capantoja/EstudioVirtualRepo/Documentacion/encoder.gif

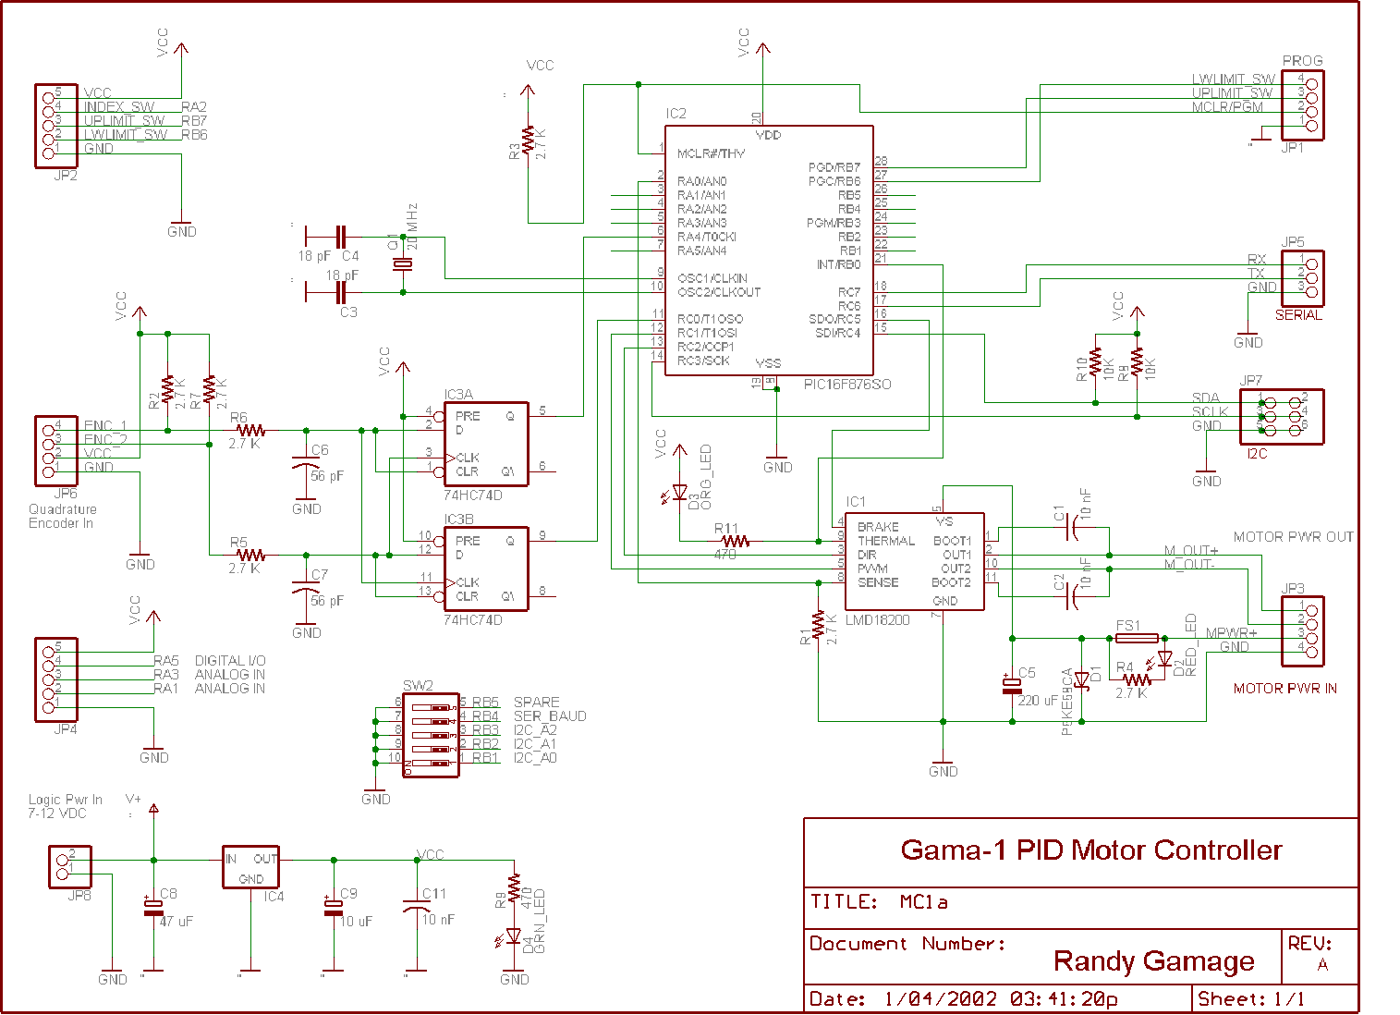
Documentacion/encoder.gif
