capantoja/EstudioVirtualRepo/Hardware/BOM.xlsx

Sheet: COMPRAS_PCB
 | UNIDADES DE PCBs: | 0
Cant requerida | Designator | Value | Descripción | Referencia Fabricante | Case | Web Link | Cantidad mínima de venta en distribuidor | Costo por un. Min. de venta | Costo por unidad | Unidades requeridas para 1 equipo | Unidades a comprar (para N PCB) | Costo de los componentes a comprar (DOLARES) | Costo de los componentes a comprar (PESOS)
COMPRAS INTERNACIONALES PCB
4 | C1,C2,C3,C4 | 10uF | Condensador de Tantalio de 10μF - 16V de montaje superficial. Tolerancia ± 10 % | CT1206 10UF16V | 1206 | http://www.sigmaelectronica.net/ct1206-10uf16v-p-1156.html | 1 | 348 | 348.000 | 4.00 |  |  | 1392
11 | C5,C6,C7,C8,C9,C10,C11,C12,C13,C14,C15 | 0.1uF | Condensador cerámico de 0.1μF - 50V de montaje superficial. Tamaño 0805 (2x1.2x1mm) | CC0805 0.1UF50 | 0805 | http://www.sigmaelectronica.net/cc0805-01uf50-p-1077.html | 10 | 58 | 58.000 | 11.00 |  |  | 638
1 | CON1 | JACK |  |  |  |  |  |  |  |  |  |  | 0
1 | J1 | DB9 | Conector DB- 9 Hembra para impreso de 9 pines. | DB9-H-IMP | - | http://www.sigmaelectronica.net/db9-h-imp-p-1578.html | 1 | 696 | 696.000 | 1.00 |  |  | 696
4 | K1,K2,K3,K4 | CONN 1X3 |  |  |  |  |  |  |  |  |  |  | 0
2 | P1,P2 | CONN 25X2 FEMALE |  |  |  |  |  |  |  |  |  |  | 0
4 | P3,P4,P5,P6 | CONN 1X5 |  |  |  |  |  |  |  |  |  |  | 0
8 | R1,R2,R3,R4,R5,R6,R7,R8 | 2.2K | Resistencia superficial de 2.2 KΩ, 1/10W | R0603 2.2K 5% | 0603 | http://www.sigmaelectronica.net/r0603-p-1675.html | 10 | 35 | 35.000 | 10.00 |  |  | 350
4 | U1,U3,U4,U6 | 74HC74M | 2 Flip-Flops tipo D con seteado y borrado. Tecnología High speed CMOS | 74HC74M | SOIC14 | http://www.sigmaelectronica.net/74hc74m-p-1138.html | 1 | 696 | 696.000 | 4.00 |  |  | 2784
1 | U5 | MAX3232 | RS232 DRIVER | MAX3232CSE | SO16 | http://www.sigmaelectronica.net/max3232cse-p-948.html | 1 | 3190 | 3190.000 | 1.00 |  |  | 3190
1 | U2 | 74HC244M | 8 buffers / tarnsmisores de línea / receptores de línea con salidas 3-state no invertidas | 74HC244M | SOIC20 | http://www.sigmaelectronica.net/74hc244m-p-704.html | 1 | 1160 | 1160.000 | 1.00 |  |  | 1160
1 |  | ATSAM3N4A | Microcontrolador 32 bits | ATSAM3N4AA-AU | LQFP48 | http://www.sigmaelectronica.net/atsam3n4aa-p-1955.html | 1 | 15486 | 15486.000 | 1.00 |  | TOTAL | 10210
COMPRAS NACIONALES PCB
 |  |  |  |  |  |  | 1 | 0 | 0.00 | 1.00 | #REF! | NV | #REF!
 |  |  |  |  |  |  | 1 | 0 | 0.00 | 1.00 | #REF! | NV | #REF!
 |  |  |  |  |  |  | 1 | 0 | 0.00 | 1.00 | #REF! | NV | #REF!
 |  |  |  |  |  |  | 1 | 0 | 0.00 | 1.00 | #REF! | NV | #REF!
 |  |  |  |  |  |  | 1 | 0 | 0.00 | 1.00 | #REF! | NV | #REF!
 |  |  |  |  |  |  | 1 | 0 | 0.00 | 1.00 | #REF! | NV | #REF!
COMPRAS INTERNACIONALES ADICIONALES AL ENSAMBLE
 |  |  |  |  |  |  | 1 | 0.89 | 0.89 | 1.00 | 1 | 0.890 | NV
 |  |  |  |  |  |  | 1 | 0.52 | 0.52 | 1.00 | 1 | 0.520 | NV
 |  |  |  |  |  |  | 1 | 0.82 | 0.82 | 5.00 | 5 | 0.000
COMPRAS NACIONALES ADICIONALES AL ENSAMBLE
 |  |  |  |  |  |  |  |  |  |  |  | TOTAL USD | 1.410
42 | TOTAL COMPONENTES POR UNIDAD: |  |  |  |  |  |  |  |  |  |  | TOTAL PESOS | #REF!
 | ÚLTIMA REVISIÓN DE STOCK: | 24/07/2014
 |  |  |  |  |  |  |  | UNIDAD PROMEDIO DOLARES: |  |  |  |  | #DIV/0!
 |  |  |  |  |  |  |  | UNIDAD PROMEDIO PESOS: |  |  |  |  | #REF!
 |  |  |  |  |  |  |  |  |  |  |  | Página 1 de 1

Sheet: COMPRAS_EQUIPOS
 |  | DEPENDENCIA |  |  | CODIGO: XXXXXXX
 |  |  |  |  | VERSION: XXXXXX
 |  | COMPRAS EQUIPOS |  |  | FECHA: [Seleccione la fecha]
Cant requerida | Nombre | Descripción | Referencia Fabricante | Web Link | Case | Web Link | Costo por unidad | Unidades a comprar | Costo de equipos (DOLARES) | Costo de equipos (PESOS)
COMPRAS NACIONALES
 |  |  |  |  |  |  |  |  | NV | 0.000
 |  |  |  |  |  |  |  |  | NV | 0.000
 |  |  |  |  |  |  |  |  | NV | 0.000
 |  |  |  |  |  |  |  |  | NV | 0.000
 |  |  |  |  |  |  |  |  | NV | 0.000
 |  |  |  |  |  |  |  |  | NV | 0.000
COMPRAS INTERNACIONALES
 |  |  |  |  |  |  |  |  | 0.000 | NV
 |  |  |  |  |  |  |  |  | 0.000 | NV
 |  |  |  |  |  |  |  |  | 0.000 | NV
 |  |  |  |  |  |  |  |  | 0.000 | NV
 |  |  |  |  |  |  |  |  | 0.000 | NV
 |  |  |  |  |  |  |  |  | 0.000 | NV
x
 |  |  |  |  |  |  |  |  | TOTAL USD | 0.000
 |  |  |  |  |  |  |  |  | TOTAL PESOS | 0
 | ÚLTIMA REVISIÓN DE STOCK: | 2011-11-01
 |  |  |  |  |  |  |  |  | Página 1 de 1
