capantoja/EstudioVirtualRepo/Hardware/Interface.pdf

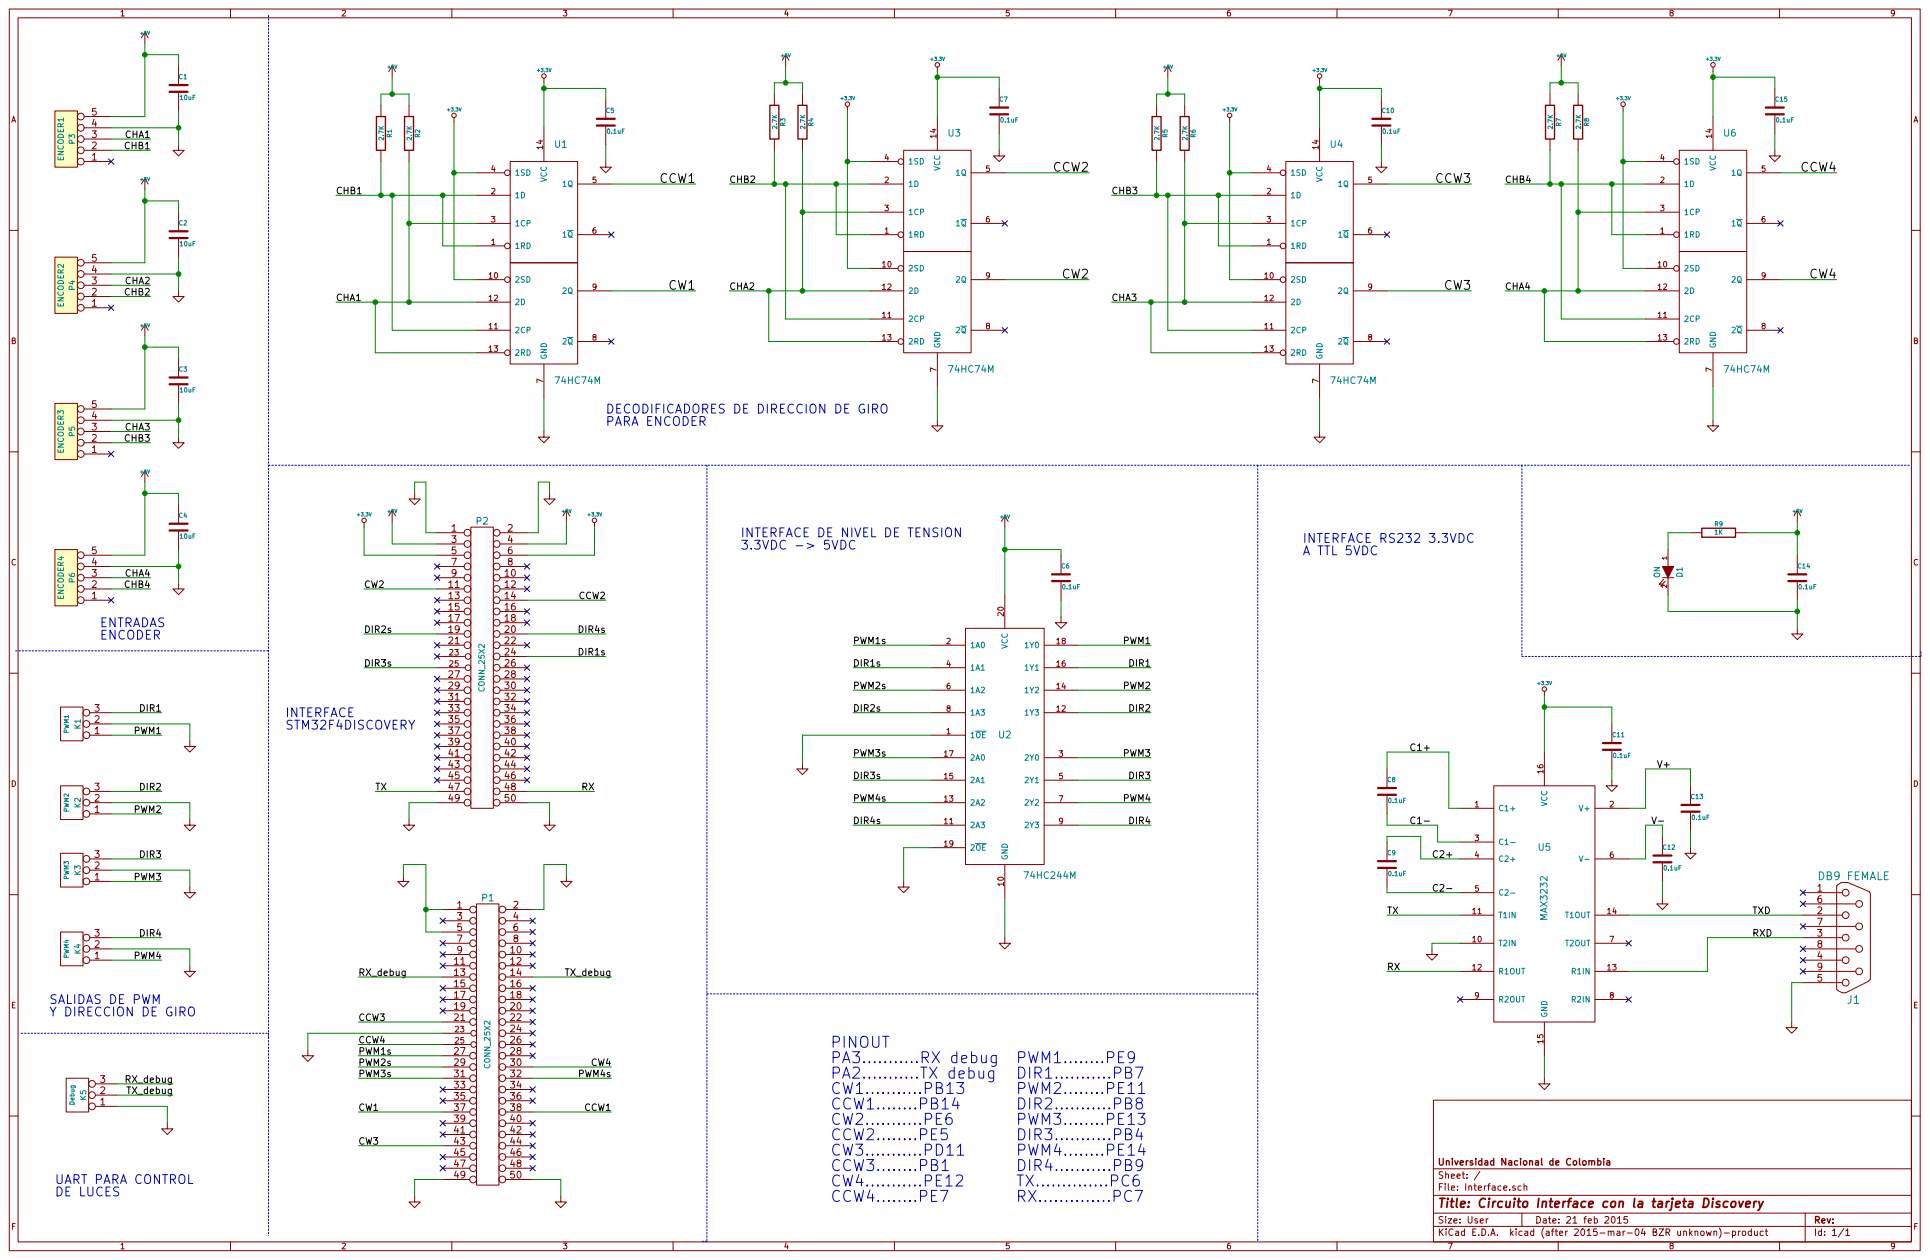
[picture p119: page 1]

INTERFACE DE NIVEL DE TENSION

File: Interface.sch Sheet: / Universidad Nacional de Colombia

Id: 1/1 Title: Circuito Interface con la tarjeta Discovery
