capantoja/EstudioVirtualRepo/Hardware/MotherBoard/MotherBoard-B_Cu.pdf

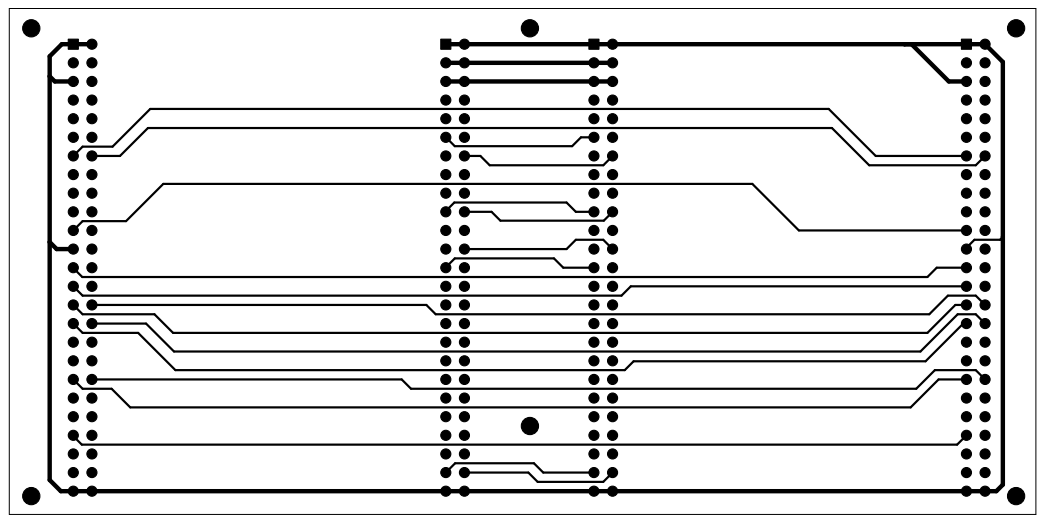
[picture p120: page 1]
