capantoja/EstudioVirtualRepo/Hardware/MotherBoard/MotherBoard-B_Cu_mirror.pdf

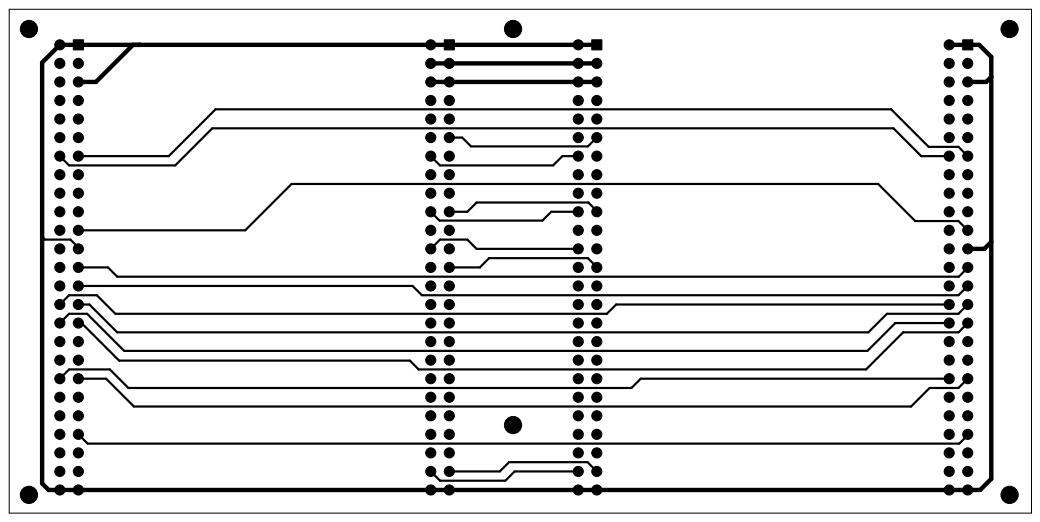
[picture p121: page 1]
