capantoja/EstudioVirtualRepo/Hardware/MotherBoard/MotherBoard-F_SilkS.pdf

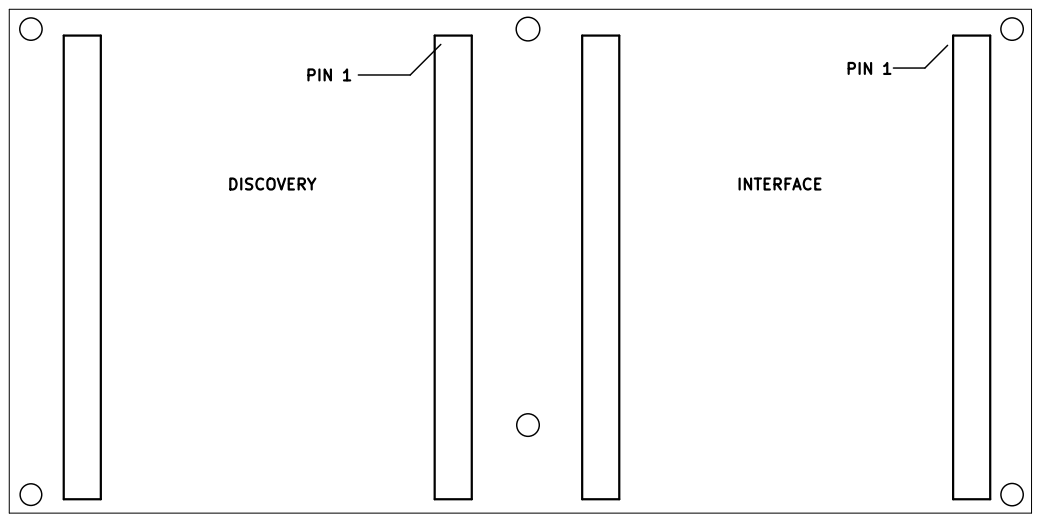
[picture p122: page 1]
