capantoja/EstudioVirtualRepo/Hardware/Interface.kicad_pcb

## KiCad design Hardware/Interface.kicad_pcb (2015-06-07)

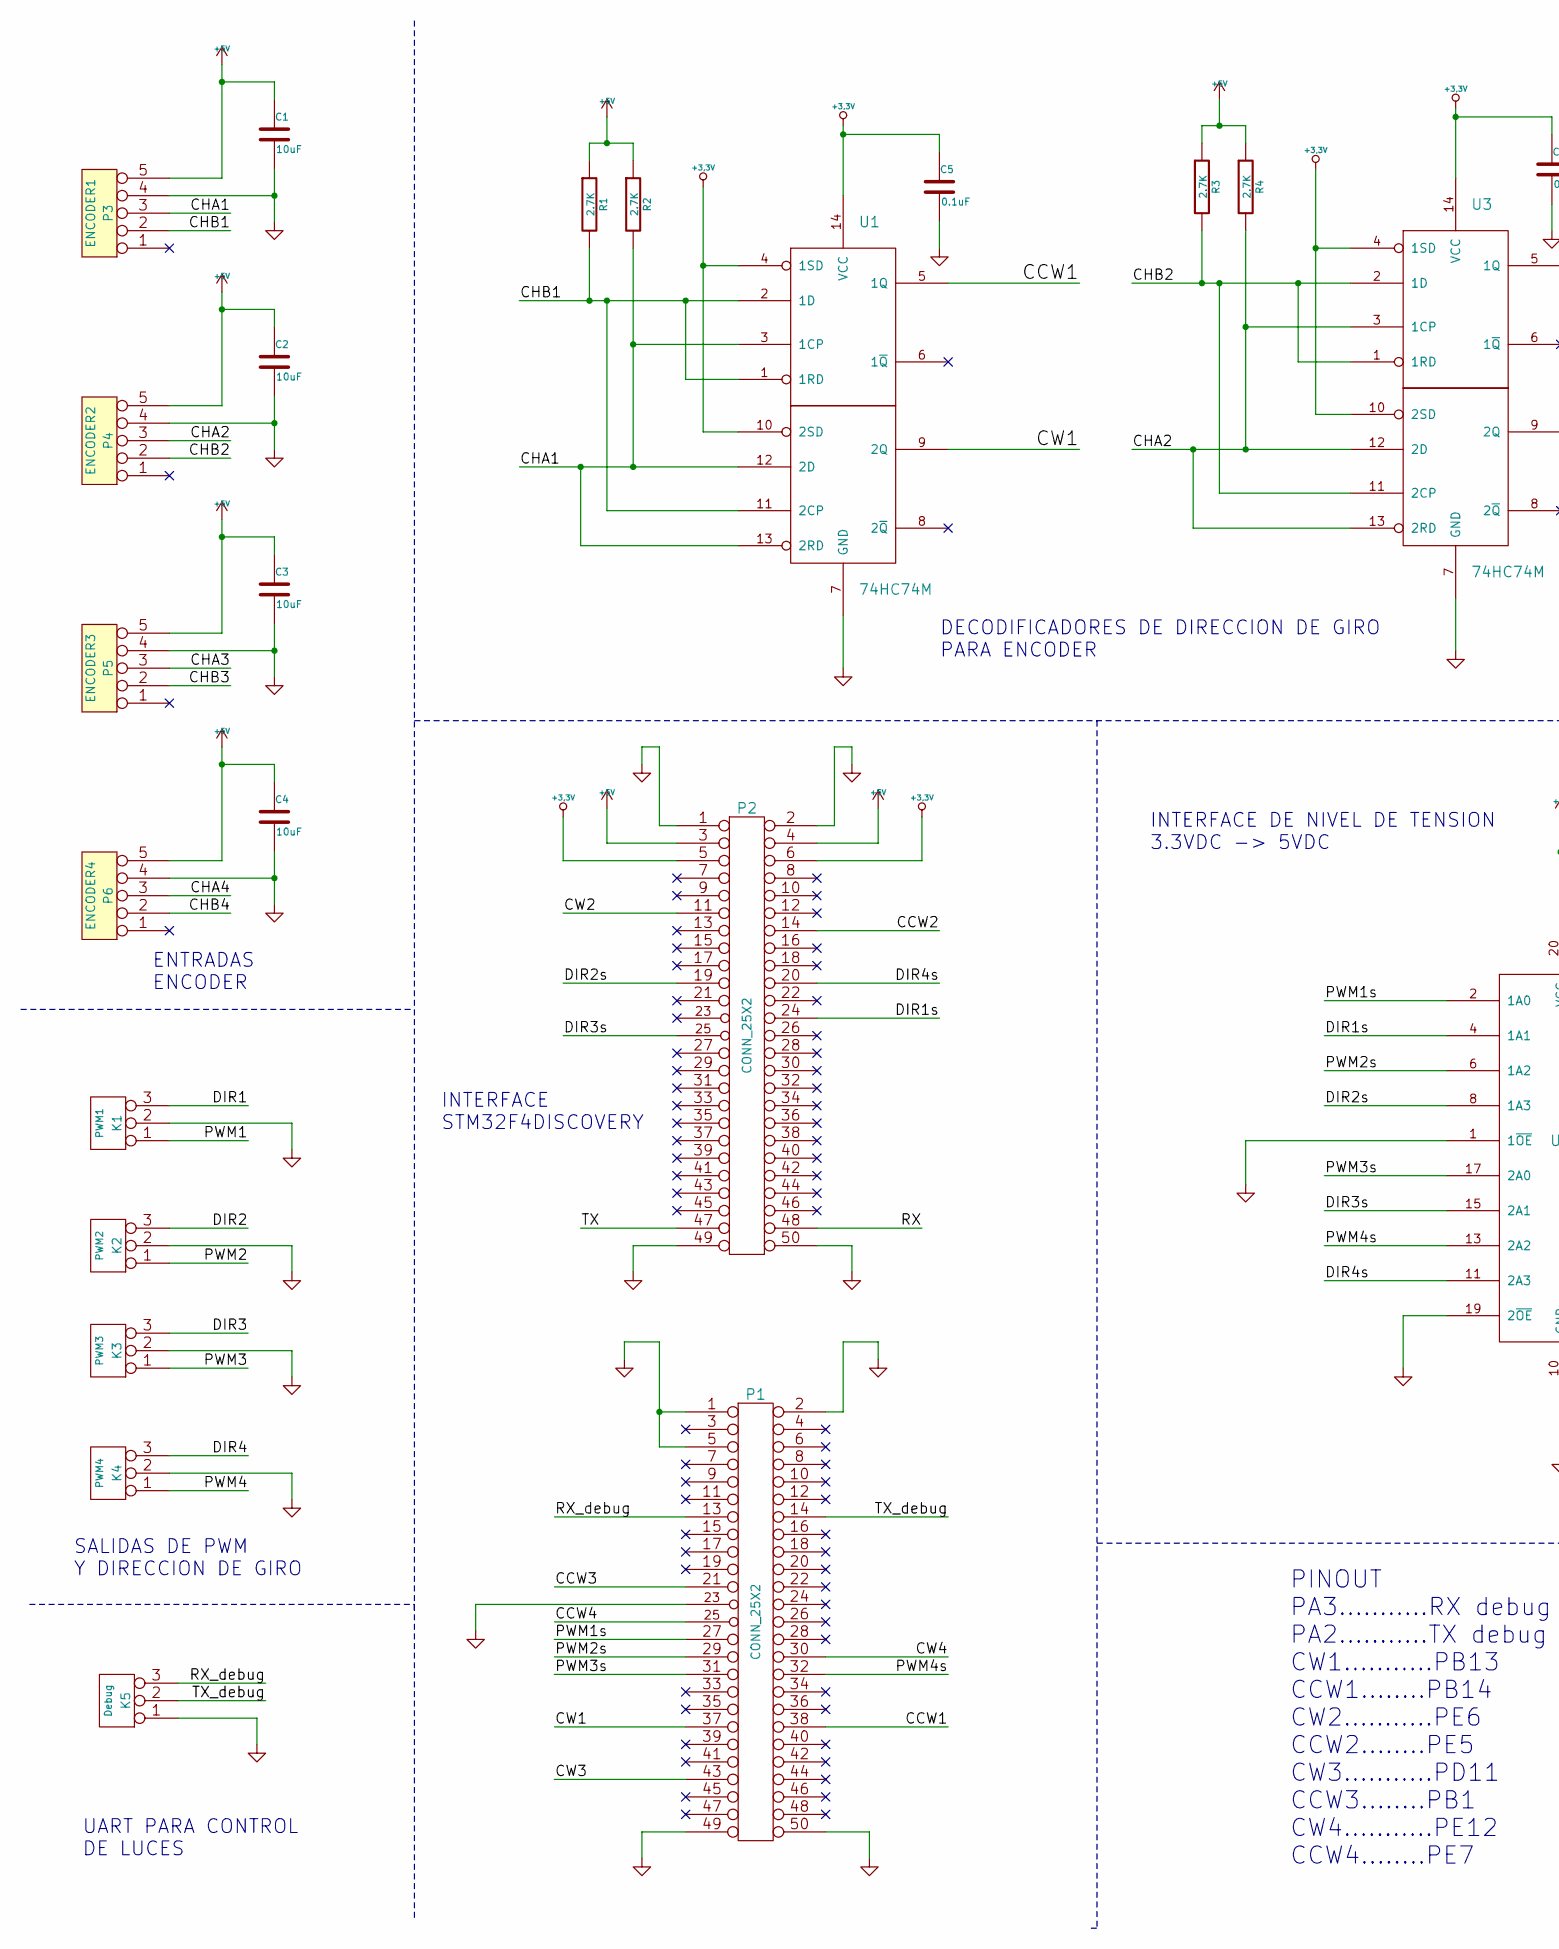
[picture p123: schematic Interface.sch, Circuito Interface con la tarjeta Discovery, part in row 1, column 1]

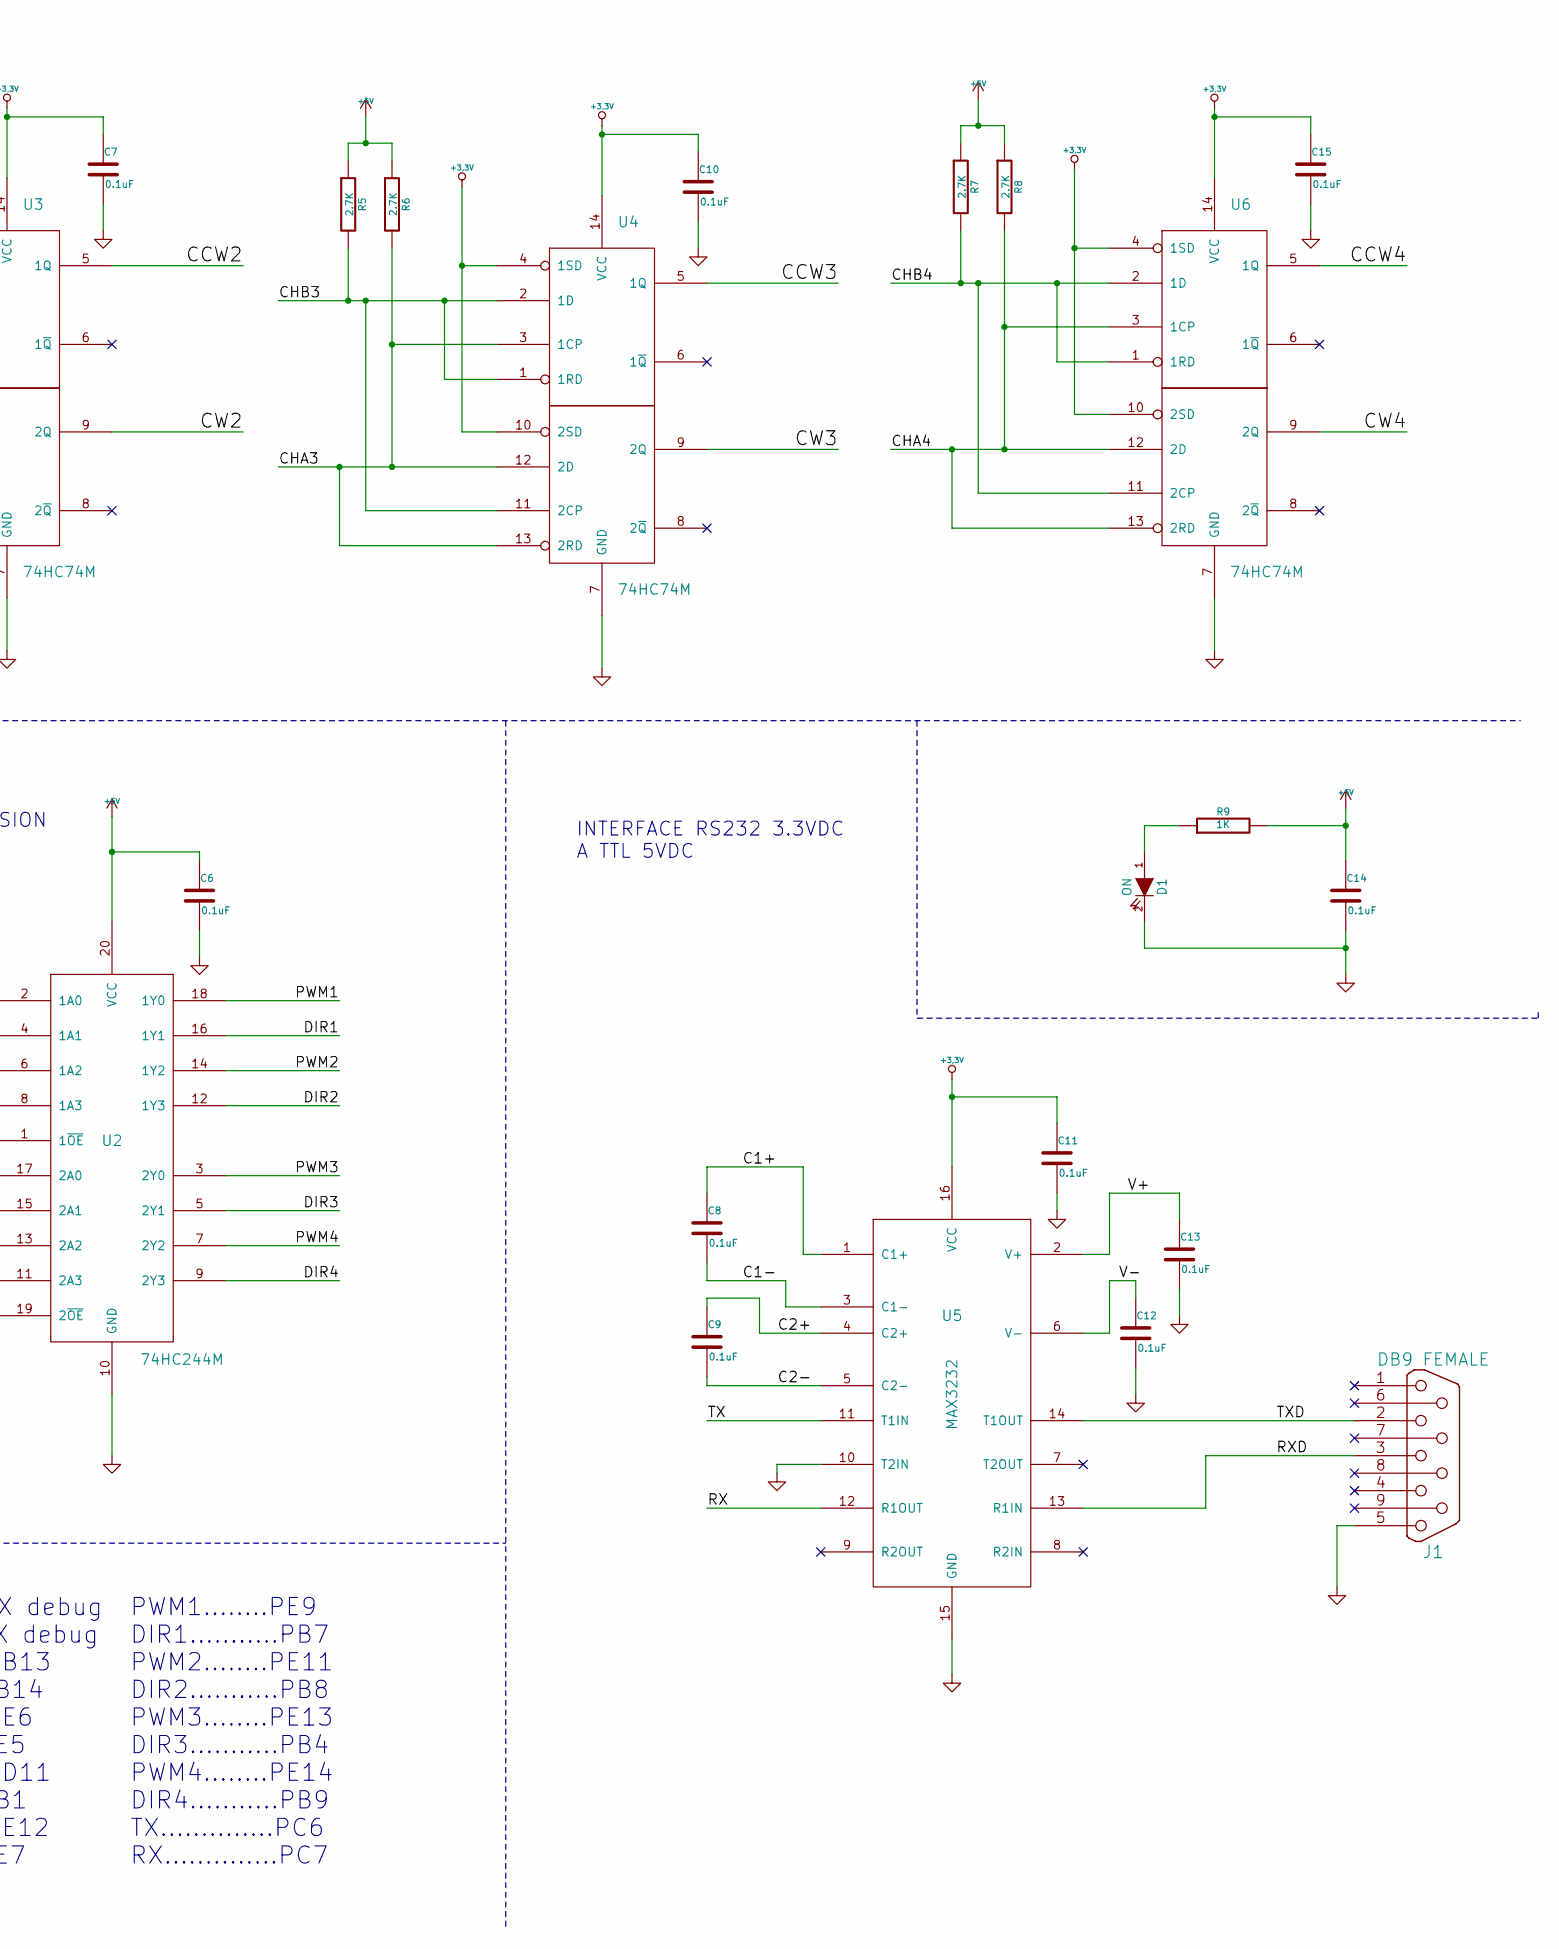
[picture p124: schematic Interface.sch, Circuito Interface con la tarjeta Discovery, part in row 1, column 2]

Parts:
C1, C2, C3, C4: 10uF
C5, C6, C7, C8, C9, C10, C11, C12, C13, C14, C15: 0.1uF
D1: ON
J1: DB9 FEMALE
K1: PWM1
K2: PWM2
K3: PWM3
K4: PWM4
K5: Debug
P1, P2: CONN_25X2
P3: ENCODER1
P4: ENCODER2
P5: ENCODER3
P6: ENCODER4
R1, R2, R3, R4, R5, R6, R7, R8: 2.7K
R9: 1K
U1, U3, U4, U6: 74HC74M
U2: 74HC244M
U5: MAX3232

Connections:
+3.3V: C5.1, C7.1, C10.1, C11.1, C15.1, P2.5, P2.6, U1.4 (1SD), U1.10 (2SD), U1.14 (VCC), U3.4 (1SD), U3.10 (2SD), U3.14 (VCC), U4.4 (1SD), U4.10 (2SD), U4.14 (VCC), U5.16 (VCC), U6.4 (1SD), U6.10 (2SD), U6.14 (VCC)
+5V: C1.1, C2.1, C3.1, C4.1, C6.1, C14.1, P2.3, P2.4, P3.5, P4.5, P5.5, P6.5, R1.1, R2.1, R3.1, R4.1, R5.1, R6.1, R7.1, R8.1, R9.2, U2.20 (VCC)
/C1+: C8.1, U5.1 (C1+)
/C1-: C8.2, U5.3 (C1-)
/C2+: C9.1, U5.4 (C2+)
/C2-: C9.2, U5.5 (C2-)
/CCW1: P1.38, U1.5 (1Q)
/CCW2: P2.14, U3.5 (1Q)
/CCW3: P1.21, U4.5 (1Q)
/CCW4: P1.25, U6.5 (1Q)
/CHA1: P3.3, R2.2, U1.3 (1CP), U1.12 (2D), U1.13 (2RD)
/CHA2: P4.3, R4.2, U3.3 (1CP), U3.12 (2D), U3.13 (2RD)
/CHA3: P5.3, R6.2, U4.3 (1CP), U4.12 (2D), U4.13 (2RD)
/CHA4: P6.3, R8.2, U6.3 (1CP), U6.12 (2D), U6.13 (2RD)
/CHB1: P3.2, R1.2, U1.1 (1RD), U1.2 (1D), U1.11 (2CP)
/CHB2: P4.2, R3.2, U3.1 (1RD), U3.2 (1D), U3.11 (2CP)
/CHB3: P5.2, R5.2, U4.1 (1RD), U4.2 (1D), U4.11 (2CP)
/CHB4: P6.2, R7.2, U6.1 (1RD), U6.2 (1D), U6.11 (2CP)
/CW1: P1.37, U1.9 (2Q)
/CW2: P2.11, U3.9 (2Q)
/CW3: P1.43, U4.9 (2Q)
/CW4: P1.30, U6.9 (2Q)
/DIR1: K1.3, U2.16 (1Y1)
/DIR1s: P2.24, U2.4 (1A1)
/DIR2: K2.3, U2.12 (1Y3)
/DIR2s: P2.19, U2.8 (1A3)
/DIR3: K3.3, U2.5 (2Y1)
/DIR3s: P2.25, U2.15 (2A1)
/DIR4: K4.3, U2.9 (2Y3)
/DIR4s: P2.20, U2.11 (2A3)
/PWM1: K1.1, U2.18 (1Y0)
/PWM1s: P1.27, U2.2 (1A0)
/PWM2: K2.1, U2.14 (1Y2)
/PWM2s: P1.29, U2.6 (1A2)
/PWM3: K3.1, U2.3 (2Y0)
/PWM3s: P1.31, U2.17 (2A0)
/PWM4: K4.1, U2.7 (2Y2)
/PWM4s: P1.32, U2.13 (2A2)
/RX: P2.48, U5.12 (R1OUT)
/RXD: J1.3, U5.13 (R1IN)
/RX_debug: K5.3, P1.13
/TX: P2.47, U5.11 (T1IN)
/TXD: J1.2, U5.14 (T1OUT)
/TX_debug: K5.2 (PM), P1.14
/V+: C13.1, U5.2 (V+)
/V-: C12.1, U5.6 (V-)
GND: C1.2, C2.2, C3.2, C4.2, C5.2, C6.2, C7.2, C10.2, C11.2, C12.2, C13.2, C14.2, C15.2, D1.2 (K), J1.5, K1.2 (PM), K2.2 (PM), K3.2 (PM), K4.2 (PM), K5.1, P1.1, P1.2, P1.5, P1.23, P1.49, P1.50, P2.1, P2.2, P2.49, P2.50, P3.4, P4.4, P5.4, P6.4, U1.7 (GND), U2.1 (1~OE), U2.10 (GND), U2.19 (2~OE), U3.7 (GND), U4.7 (GND), U5.10 (T2IN), U5.15 (GND), U6.7 (GND)
unnamed: D1.1 (A), R9.1

Notes on the sheet:
PINOUT PA3...........RX debug PA2...........TX debug CW1...........PB13 CCW1........PB14 CW2...........PE6 CCW2........PE5 CW3...........PD11 CCW3........PB1 CW4...........PE12 CCW4........PE7
PWM1........PE9 DIR1...........PB7 PWM2........PE11 DIR2...........PB8 PWM3........PE13 DIR3...........PB4 PWM4........PE14 DIR4...........PB9 TX..............PC6 RX..............PC7
DECODIFICADORES DE DIRECCION DE GIRO PARA ENCODER
INTERFACE DE NIVEL DE TENSION 3.3VDC -> 5VDC
INTERFACE RS232 3.3VDC A TTL 5VDC
ENTRADAS ENCODER
SALIDAS DE PWM Y DIRECCION DE GIRO
UART PARA CONTROL DE LUCES
INTERFACE STM32F4DISCOVERY

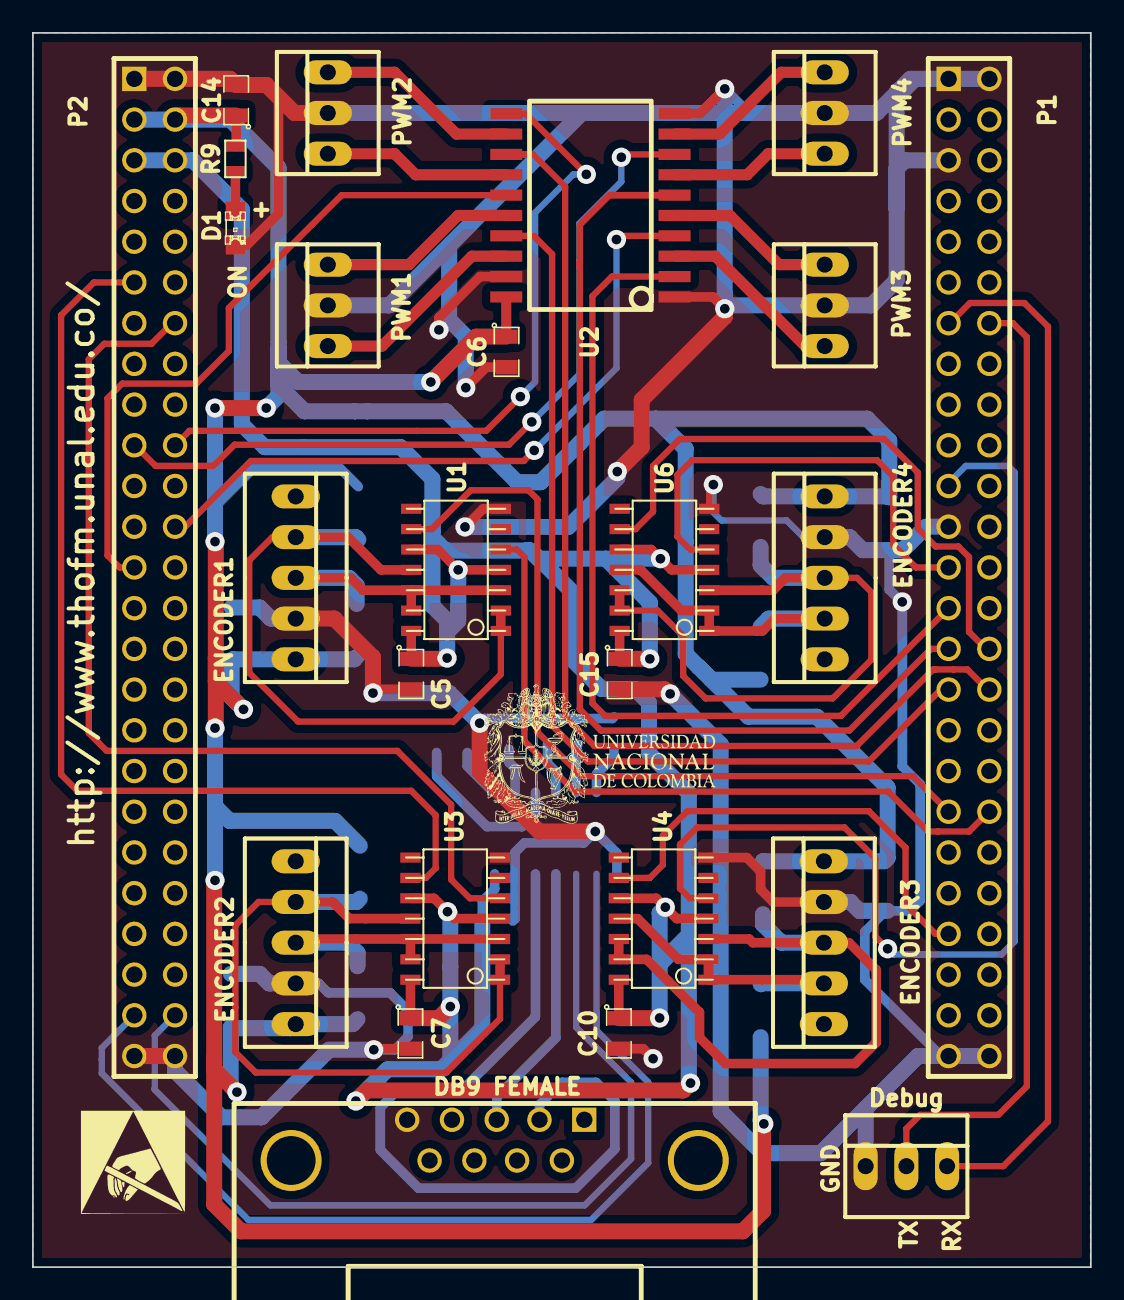
[picture p125: board Interface.kicad_pcb from above]

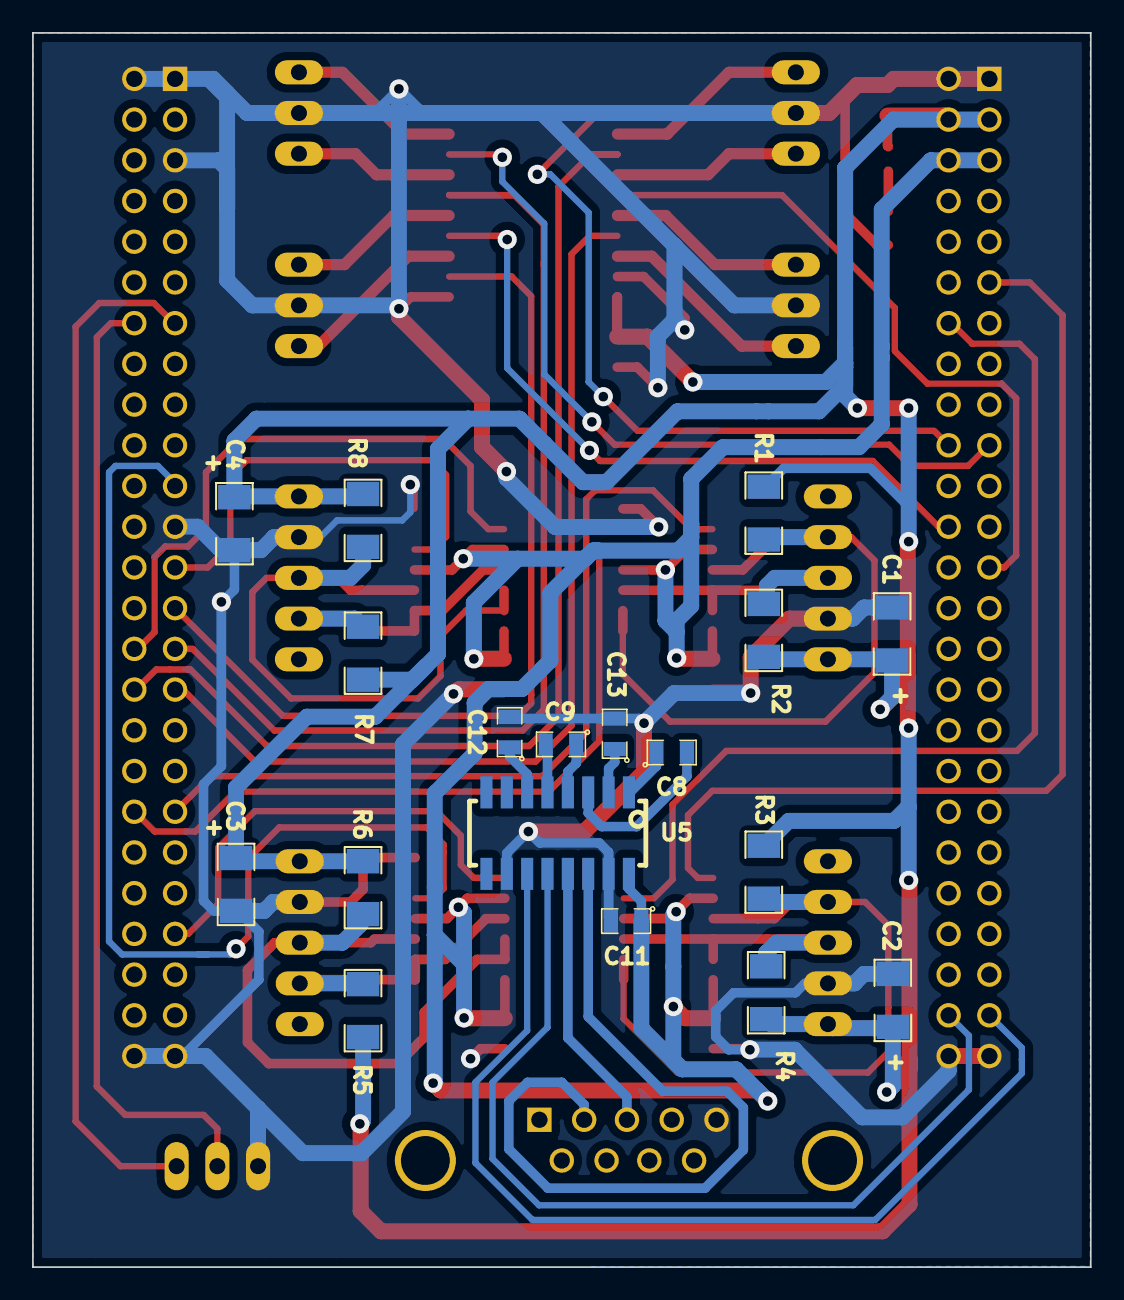
[picture p126: board Interface.kicad_pcb from below]

Board: 2 copper layers, 66.0 x 77.0 mm, 45 parts (18 on the bottom side), 48 nets.

Other parts of the board:
VAL: REF; ElectroStaticLogo
VAL#2: REF; UnalLogo
