capantoja/EstudioVirtualRepo/Software/ChibiOS_2.6.8_PodioVirtual/os/ports/GCC/ARMCMx/crt0.c

/*
    ChibiOS/RT - Copyright (C) 2006,2007,2008,2009,2010,
                 2011,2012,2013 Giovanni Di Sirio.

    This file is part of ChibiOS/RT.

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
                                      ---

    A special exception to the GPL can be applied should you wish to distribute
    a combined work that includes ChibiOS/RT, without being obliged to provide
    the source code for any proprietary components. See the file exception.txt
    for full details of how and when the exception can be applied.
*/

/**
 * @file    ARMCMx/crt0.c
 * @brief   Generic ARMvx-M (Cortex-M0/M1/M3/M4) startup file for ChibiOS/RT.
 *
 * @addtogroup ARMCMx_STARTUP
 * @{
 */

#include <stdint.h>

#if !defined(FALSE)
#define FALSE       0
#endif

#if !defined(TRUE)
#define TRUE        (!FALSE)
#endif

#define SCB_CPACR               *((uint32_t *)0xE000ED88U)
#define SCB_FPCCR               *((uint32_t *)0xE000EF34U)
#define SCB_FPDSCR              *((uint32_t *)0xE000EF3CU)
#define FPCCR_ASPEN             (0x1U << 31)
#define FPCCR_LSPEN             (0x1U << 30)

typedef void (*funcp_t)(void);
typedef funcp_t * funcpp_t;

#define SYMVAL(sym) (uint32_t)(((uint8_t *)&(sym)) - ((uint8_t *)0))

/*
 * Area fill code, it is a macro because here functions cannot be called
 * until stacks are initialized.
 */
#define fill32(start, end, filler) {                                        \
  uint32_t *p1 = start;                                                     \
  uint32_t *p2 = end;                                                       \
  while (p1 < p2)                                                           \
    *p1++ = filler;                                                         \
}

/*===========================================================================*/
/**
 * @name    Startup settings
 * @{
 */
/*===========================================================================*/

/**
 * @brief   Control special register initialization value.
 * @details The system is setup to run in privileged mode using the PSP
 *          stack (dual stack mode).
 */
#if !defined(CRT0_CONTROL_INIT) || defined(__DOXYGEN__)
#define CRT0_CONTROL_INIT           0x00000002
#endif

/**
 * @brief   Stack segments initialization switch.
 */
#if !defined(CRT0_STACKS_FILL_PATTERN) || defined(__DOXYGEN__)
#define CRT0_STACKS_FILL_PATTERN    0x55555555
#endif

/**
 * @brief   Stack segments initialization switch.
 */
#if !defined(CRT0_INIT_STACKS) || defined(__DOXYGEN__)
#define CRT0_INIT_STACKS            TRUE
#endif

/**
 * @brief   DATA segment initialization switch.
 */
#if !defined(CRT0_INIT_DATA) || defined(__DOXYGEN__)
#define CRT0_INIT_DATA              TRUE
#endif
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
