capantoja/EstudioVirtualRepo/(commit log)

2015-06-07 Documentacion file add
    [NC-drill.drl]
2015-06-07 Gerber file add
    [Interface-B_Cu.gbl, Interface-B_Mask.gbs, Interface-B_SilkS.gbo, Interface-F_Cu.gtl, Interface-F_Mask.gts, Interface-F_SilkS.gto, Interface.drl]
2015-06-07 Hardware project add
    [BOM.xlsx, Interface.csv, Interface.kicad_pcb, Interface.sch, MotherBoard.kicad_pcb, MotherBoard.sch]
2015-06-07 BOM add
    [BOM.csv]
2015-06-07 BOM pdf add
